Omar-Elkhabbty/Quadcopter-Drone/Hardware List.xlsx

Microcontroller
ESP32-WROOM-32 (DevKit v1 - 38 Pins)
Sensors Suite
IMU
Barometer
GPS Module
Camera & Video Stream
ESP32-CAM and MicroSD
Radio Control Link
FlySky FS-i6 (2.4GHz 6-channel) (Transmitter)
FlySky FS-iA6B (Receiver)
Propulsion System
A2212 1000KV BLDC Motors
30A BLHeli_S ESCs
1045 Propellers
Power System & Protection
LiPo 3S 11.1V 2200mAh
PDB with Dual BEC (5V / 12V
Voltage Divider Module
IMAX B6 LiPo Balance Charger
Frame & Mechanical Hardware
F450 Frame
Anti-Vibration Dampening rubber pads
