Omar-Elkhabbty/Quadcopter-Drone/Quadcopter_RevA.kicad_sch

## KiCad design Quadcopter_RevA.kicad_sch (2026-11-09)

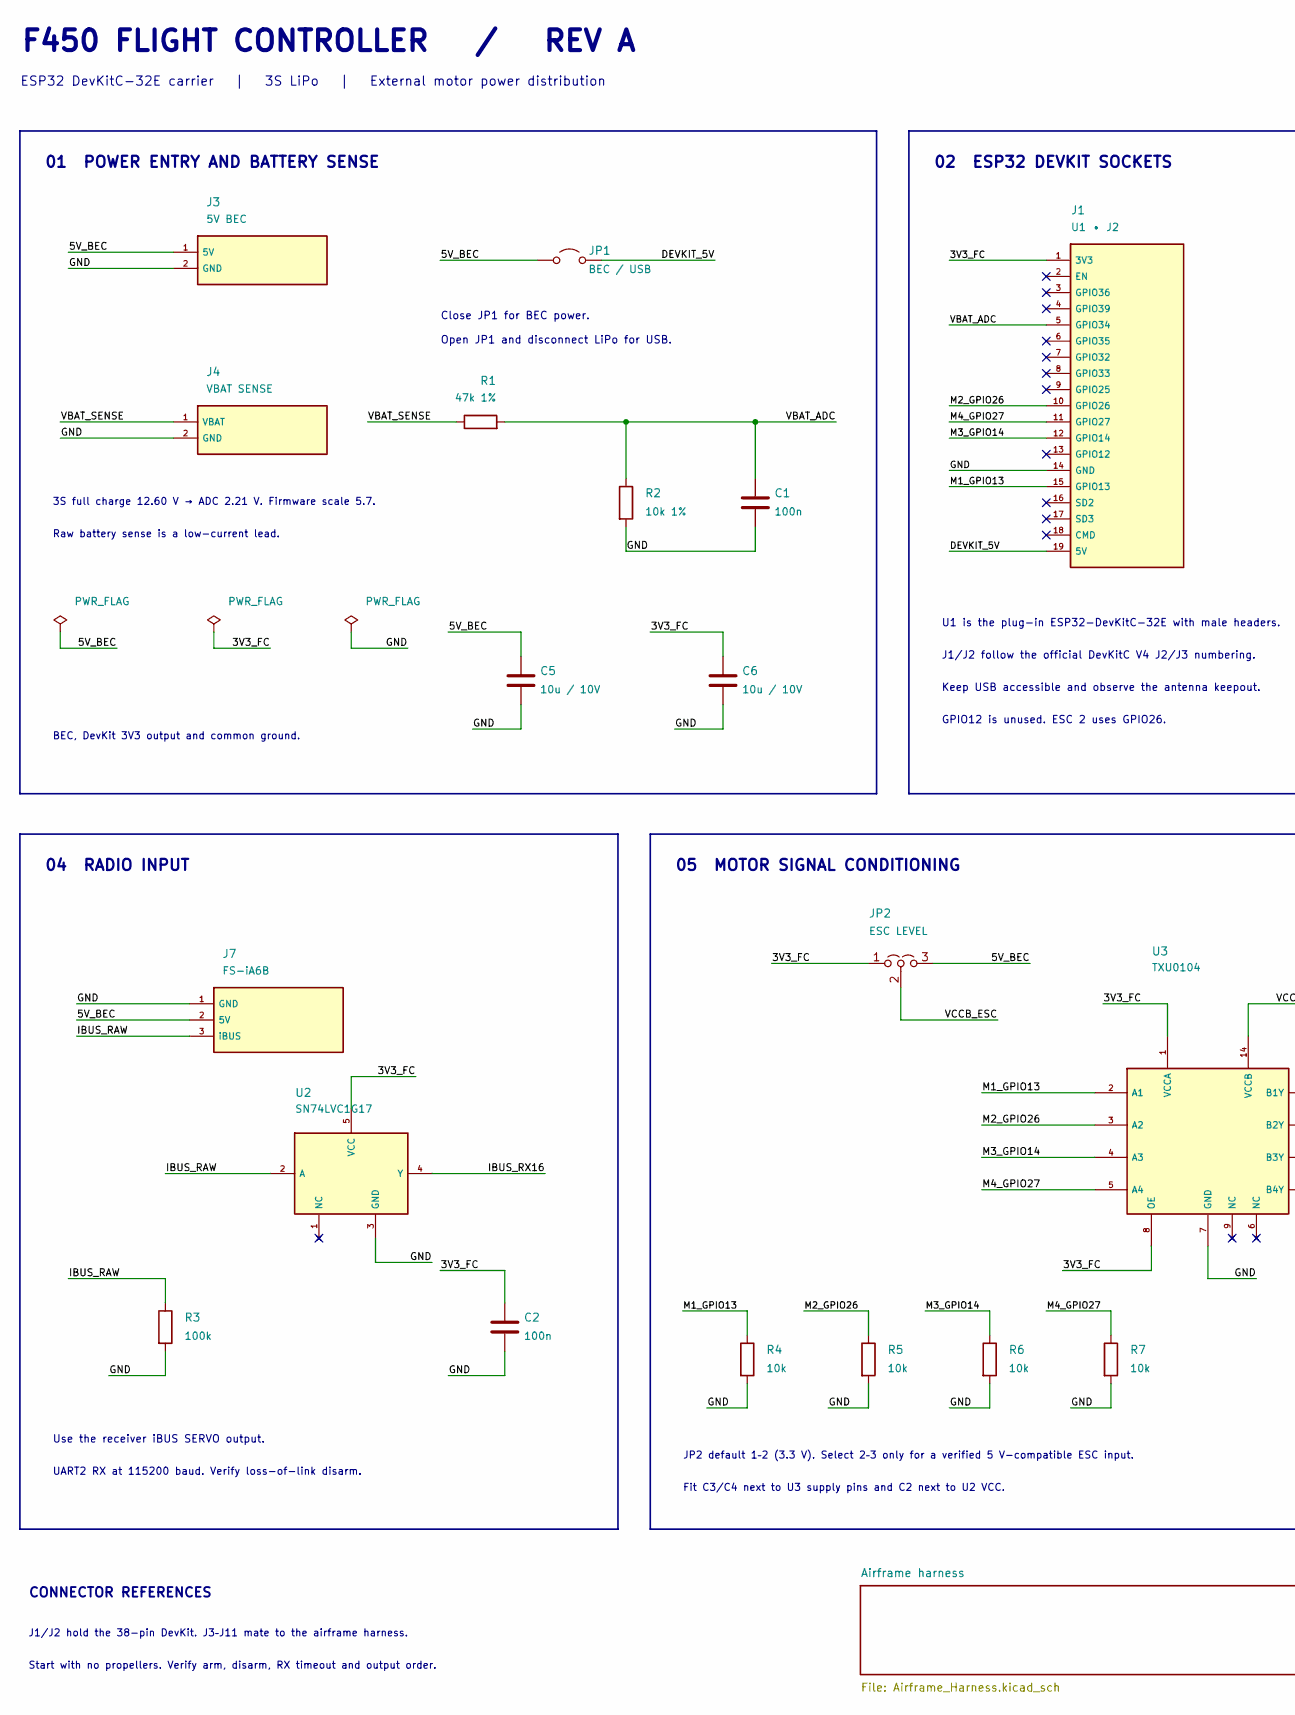
[picture p1: schematic Quadcopter_RevA.kicad_sch, part in row 1, column 1]

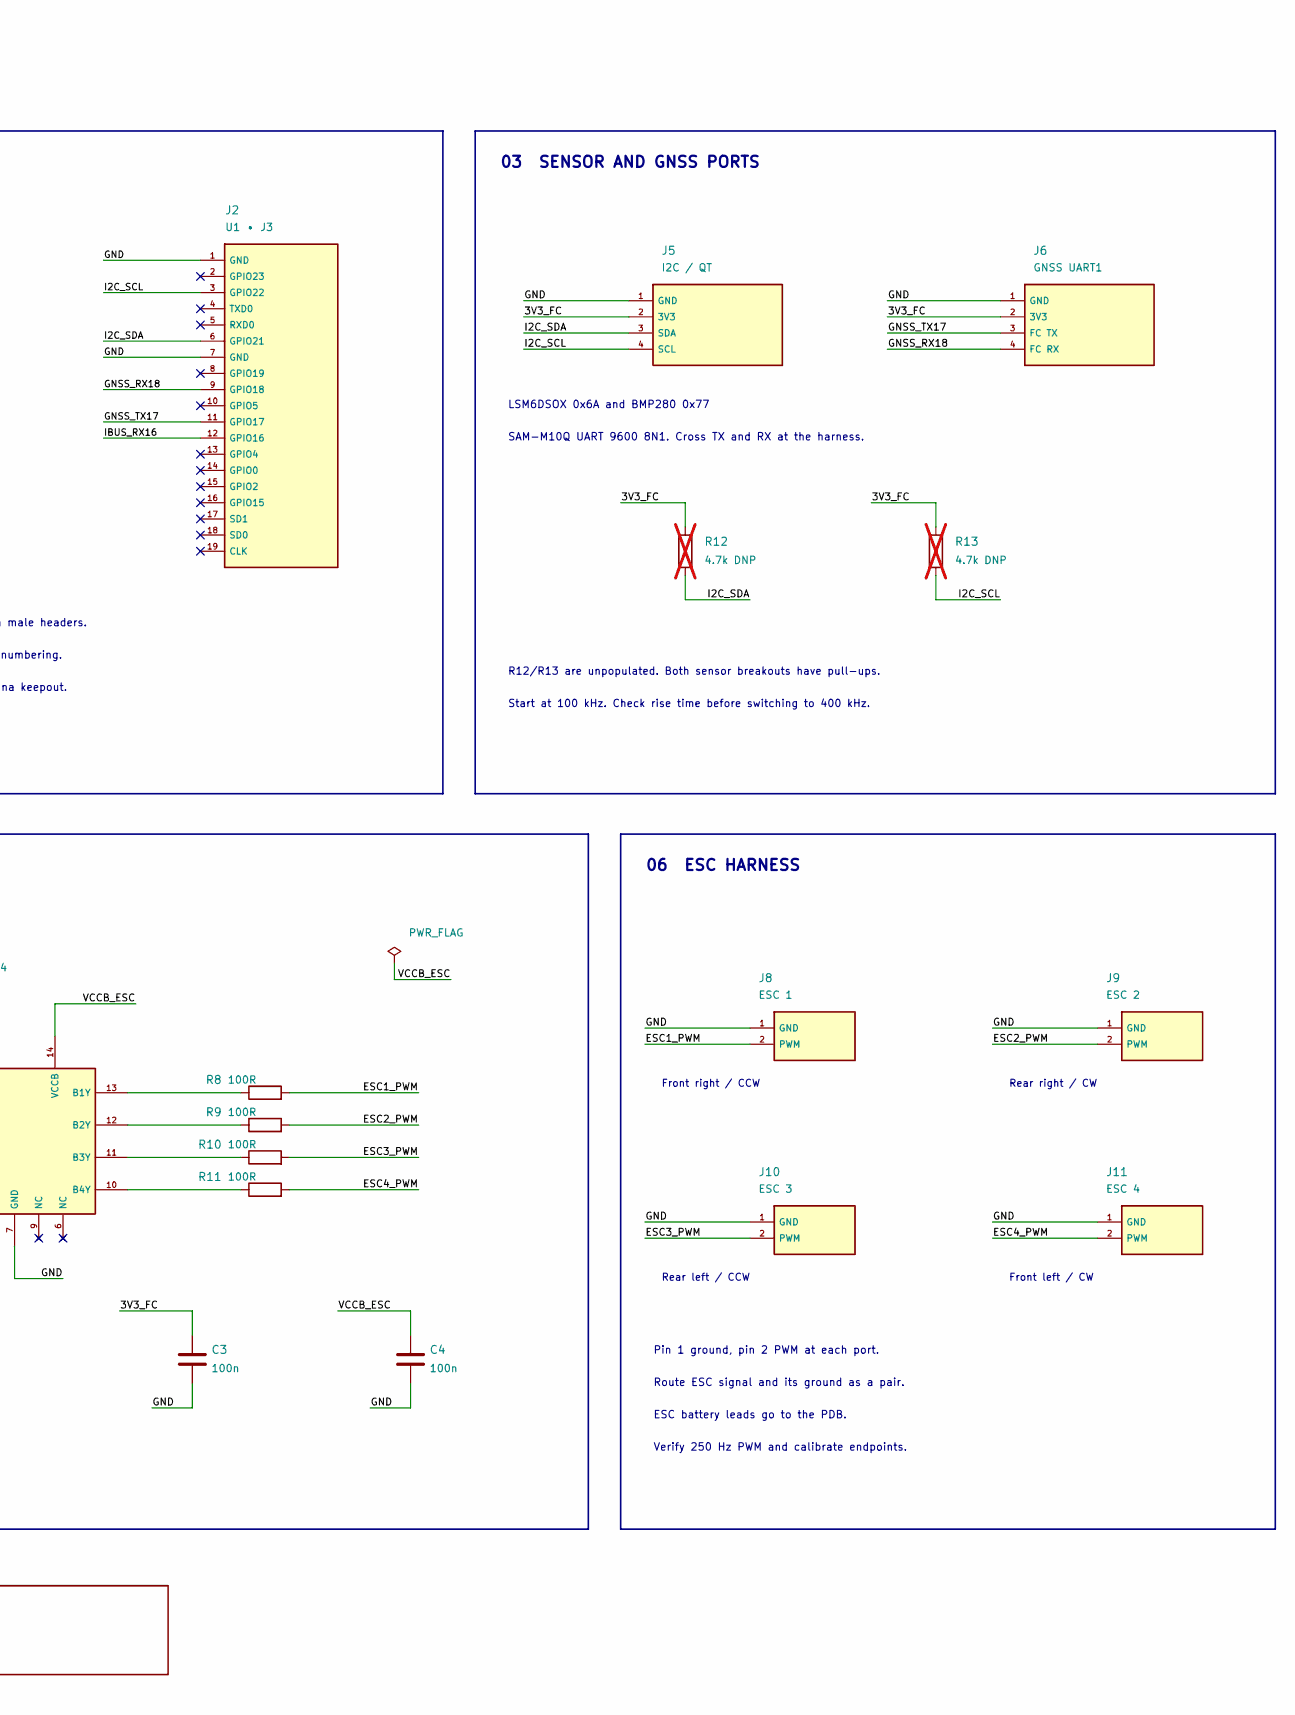
[picture p2: schematic Quadcopter_RevA.kicad_sch, part in row 1, column 2]

Parts:
C1, C2, C3, C4: 100n; C_0603_1608Metric; MPN GRM188R71H104KA93D
C5, C6: 10u / 10V; C_0805_2012Metric; MPN GRM21BR71A106KA73L
J1: U1 • J2; PinSocket_1x19_P2.54mm_Vertical; MPN SSW-119-01-G-S
J2: U1 • J3; PinSocket_1x19_P2.54mm_Vertical; MPN SSW-119-01-G-S
J3: 5V BEC; JST_VH_B2P-VH_1x02_P3.96mm_Vertical; MPN B2P-VH(LF)(SN)
J4: VBAT SENSE; SolderWire-0.127sqmm_1x02_P3.7mm_D0.48mm_OD1mm_Relief
J5: I2C / QT; JST_SH_SM04B-SRSS-TB_1x04-1MP_P1.00mm_Horizontal; MPN SM04B-SRSS-TB(LF)(SN)
J6: GNSS UART1; JST_XH_B4B-XH-A_1x04_P2.50mm_Vertical; MPN B4B-XH-A(LF)(SN)
J7: FS-iA6B; JST_XH_B3B-XH-A_1x03_P2.50mm_Vertical; MPN B3B-XH-A(LF)(SN)
J8: ESC 1; JST_XH_B2B-XH-A_1x02_P2.50mm_Vertical; MPN B2B-XH-A(LF)(SN)
J9: ESC 2; JST_XH_B2B-XH-A_1x02_P2.50mm_Vertical; MPN B2B-XH-A(LF)(SN)
J10: ESC 3; JST_XH_B2B-XH-A_1x02_P2.50mm_Vertical; MPN B2B-XH-A(LF)(SN)
J11: ESC 4; JST_XH_B2B-XH-A_1x02_P2.50mm_Vertical; MPN B2B-XH-A(LF)(SN)
JP1: BEC / USB; PinHeader_1x02_P2.54mm_Vertical; MPN TSW-102-07-G-S
JP2: ESC LEVEL; PinHeader_1x03_P2.54mm_Vertical; MPN TSW-103-07-G-S
R1: 47k 1%; R_0603_1608Metric; MPN RC0603FR-0747KL
R2: 10k 1%; R_0603_1608Metric; MPN RC0603FR-0710KL
R3: 100k; R_0603_1608Metric; MPN RC0603FR-07100KL
R4, R5, R6, R7: 10k; R_0603_1608Metric; MPN RC0603FR-0710KL
R8, R9, R10, R11: 100R; R_0603_1608Metric; MPN RC0603FR-07100RL
R12, R13: 4.7k DNP; R_0603_1608Metric; MPN RC0603FR-074K7L; not fitted
U2: SN74LVC1G17; SOT-23-5; MPN SN74LVC1G17DBVR
U3: TXU0104; TSSOP-14_4.4x5mm_P0.65mm; MPN TXU0104PWR

Connections:
3V3_FC: C2.1, C3.1, C6.1, J1.1 (3V3), J5.2 (3V3), J6.2 (3V3), JP2.1 (A), R12.1, R13.1, U2.5 (VCC), U3.1 (VCCA), U3.8 (OE)
5V_BEC: C5.1, J3.1 (5V), J7.2 (5V), JP1.1 (A), JP2.3 (B)
DEVKIT_5V: J1.19 (5V), JP1.2 (B)
ESC1_PWM: J8.2 (PWM), R8.2
ESC2_PWM: J9.2 (PWM), R9.2
ESC3_PWM: J10.2 (PWM), R10.2
ESC4_PWM: J11.2 (PWM), R11.2
GND: C1.2, C2.2, C3.2, C4.2, C5.2, C6.2, J1.14 (GND), J2.1 (GND), J2.7 (GND), J3.2 (GND), J4.2 (GND), J5.1 (GND), J6.1 (GND), J7.1 (GND), J8.1 (GND), J9.1 (GND), J10.1 (GND), J11.1 (GND), R2.2, R3.2, R4.2, R5.2, R6.2, R7.2, U2.3 (GND), U3.7 (GND)
GNSS_RX18: J2.9 (GPIO18), J6.4 (FC RX)
GNSS_TX17: J2.11 (GPIO17), J6.3 (FC TX)
I2C_SCL: J2.3 (GPIO22), J5.4 (SCL), R13.2
I2C_SDA: J2.6 (GPIO21), J5.3 (SDA), R12.2
IBUS_RAW: J7.3 (iBUS), R3.1, U2.2 (A)
IBUS_RX16: J2.12 (GPIO16), U2.4 (Y)
M1_GPIO13: J1.15 (GPIO13), R4.1, U3.2 (A1)
M2_GPIO26: J1.10 (GPIO26), R5.1, U3.3 (A2)
M3_GPIO14: J1.12 (GPIO14), R6.1, U3.4 (A3)
M4_GPIO27: J1.11 (GPIO27), R7.1, U3.5 (A4)
unnamed: R8.1, U3.13 (B1Y)
unnamed: R9.1, U3.12 (B2Y)
unnamed: R10.1, U3.11 (B3Y)
unnamed: R11.1, U3.10 (B4Y)
VBAT_ADC: C1.1, J1.5 (GPIO34), R1.2, R2.1
VBAT_SENSE: J4.1 (VBAT), R1.1
VCCB_ESC: C4.1, JP2.2 (C), U3.14 (VCCB)

Notes on the sheet:
F450 FLIGHT CONTROLLER / REV A
ESP32 DevKitC-32E carrier | 3S LiPo | External motor power distribution
01 POWER ENTRY AND BATTERY SENSE
02 ESP32 DEVKIT SOCKETS
03 SENSOR AND GNSS PORTS
04 RADIO INPUT
05 MOTOR SIGNAL CONDITIONING
06 ESC HARNESS
Close JP1 for BEC power.
Open JP1 and disconnect LiPo for USB.
3S full charge 12.60 V → ADC 2.21 V. Firmware scale 5.7.
Raw battery sense is a low-current lead.
BEC, DevKit 3V3 output and common ground.
U1 is the plug-in ESP32-DevKitC-32E with male headers.
J1/J2 follow the official DevKitC V4 J2/J3 numbering.
Keep USB accessible and observe the antenna keepout.
GPIO12 is unused. ESC 2 uses GPIO26.
LSM6DSOX 0x6A and BMP280 0x77
SAM-M10Q UART 9600 8N1. Cross TX and RX at the harness.
R12/R13 are unpopulated. Both sensor breakouts have pull-ups.
Start at 100 kHz. Check rise time before switching to 400 kHz.
Use the receiver iBUS SERVO output.
UART2 RX at 115200 baud. Verify loss-of-link disarm.
JP2 default 1–2 (3.3 V). Select 2–3 only for a verified 5 V-compatible ESC input.
Fit C3/C4 next to U3 supply pins and C2 next to U2 VCC.
Front right / CCW
Rear right / CW
Rear left / CCW
Front left / CW
Pin 1 ground, pin 2 PWM at each port.
Route ESC signal and its ground as a pair.
ESC battery leads go to the PDB.
Verify 250 Hz PWM and calibrate endpoints.
CONNECTOR REFERENCES
J1/J2 hold the 38-pin DevKit. J3–J11 mate to the airframe harness.
Start with no propellers. Verify arm, disarm, RX timeout and output order.
