Omar-Elkhabbty/Quadcopter-Drone/(notices)

Notices in the files:
README.md:
License: All Rights Reserved
